carollustirtaagni-collab/proyek-kipas-edge-ai/data/_uji_i2c/sehat_u01_pwm100_20260928-003612.png

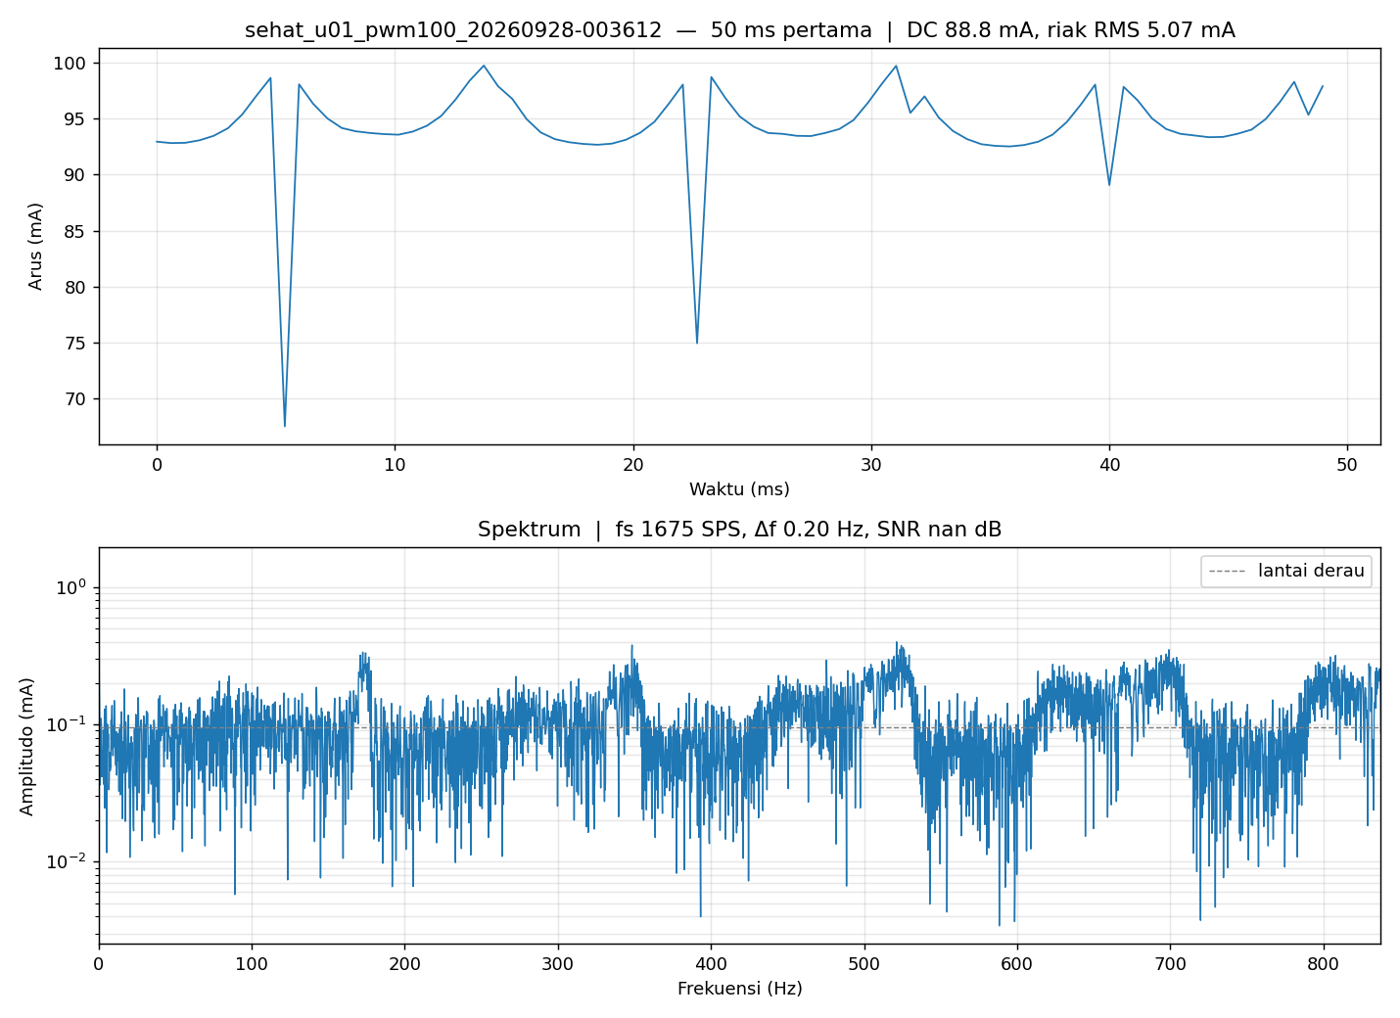
data/_uji_i2c/sehat_u01_pwm100_20260928-003612.png
