carollustirtaagni-collab/proyek-kipas-edge-ai/data/_uji_led/cek-led_20261019-214011.png

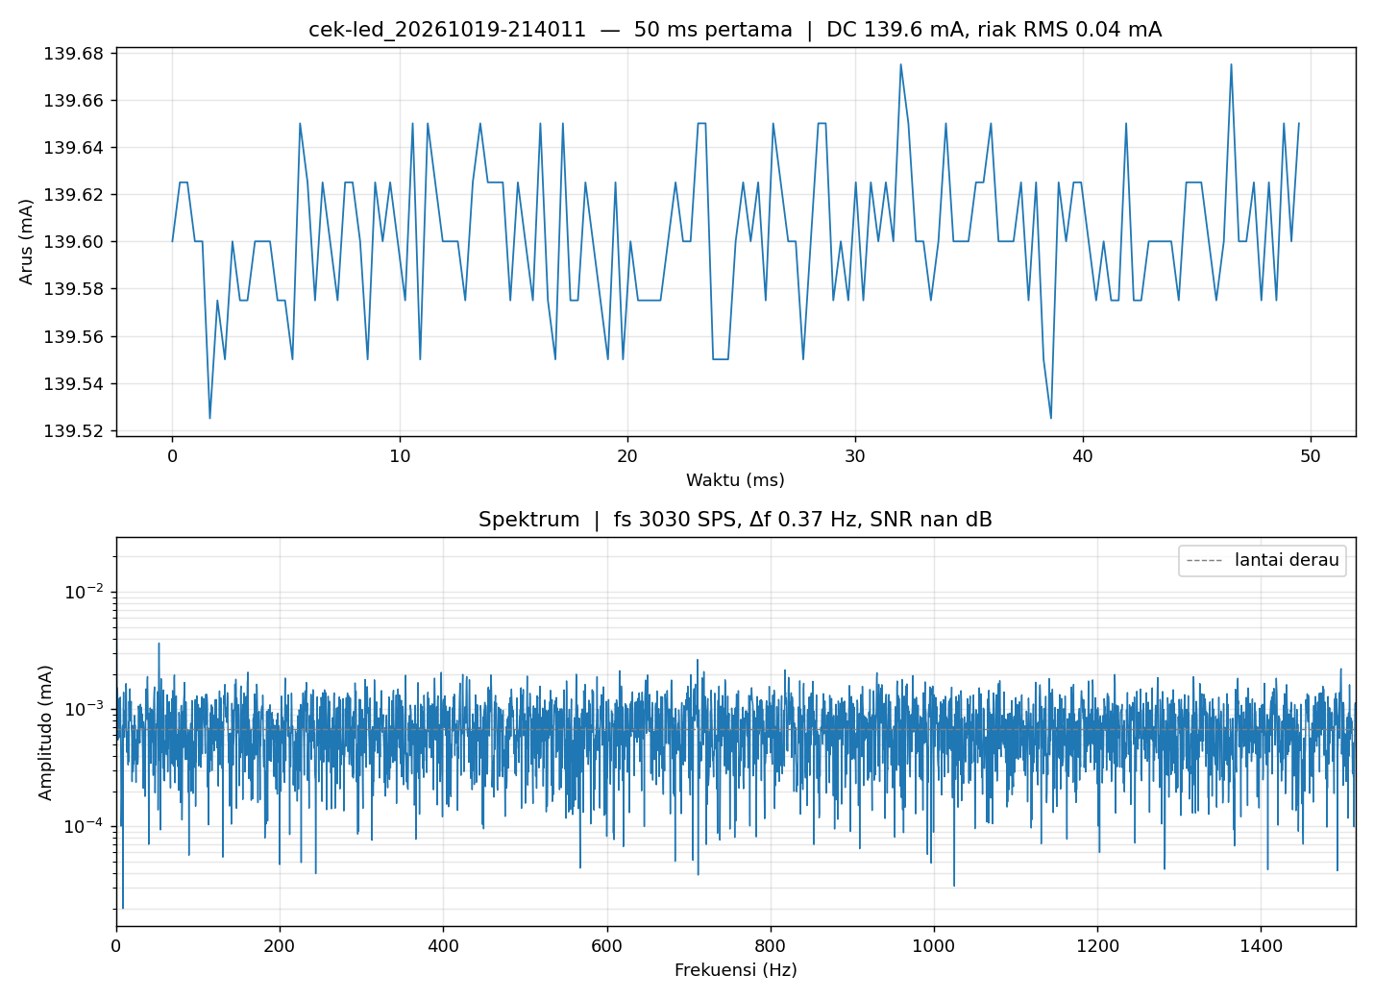
data/_uji_led/cek-led_20261019-214011.png
