carollustirtaagni-collab/proyek-kipas-edge-ai/data/_uji_led/cek-led_20261019-214037.png

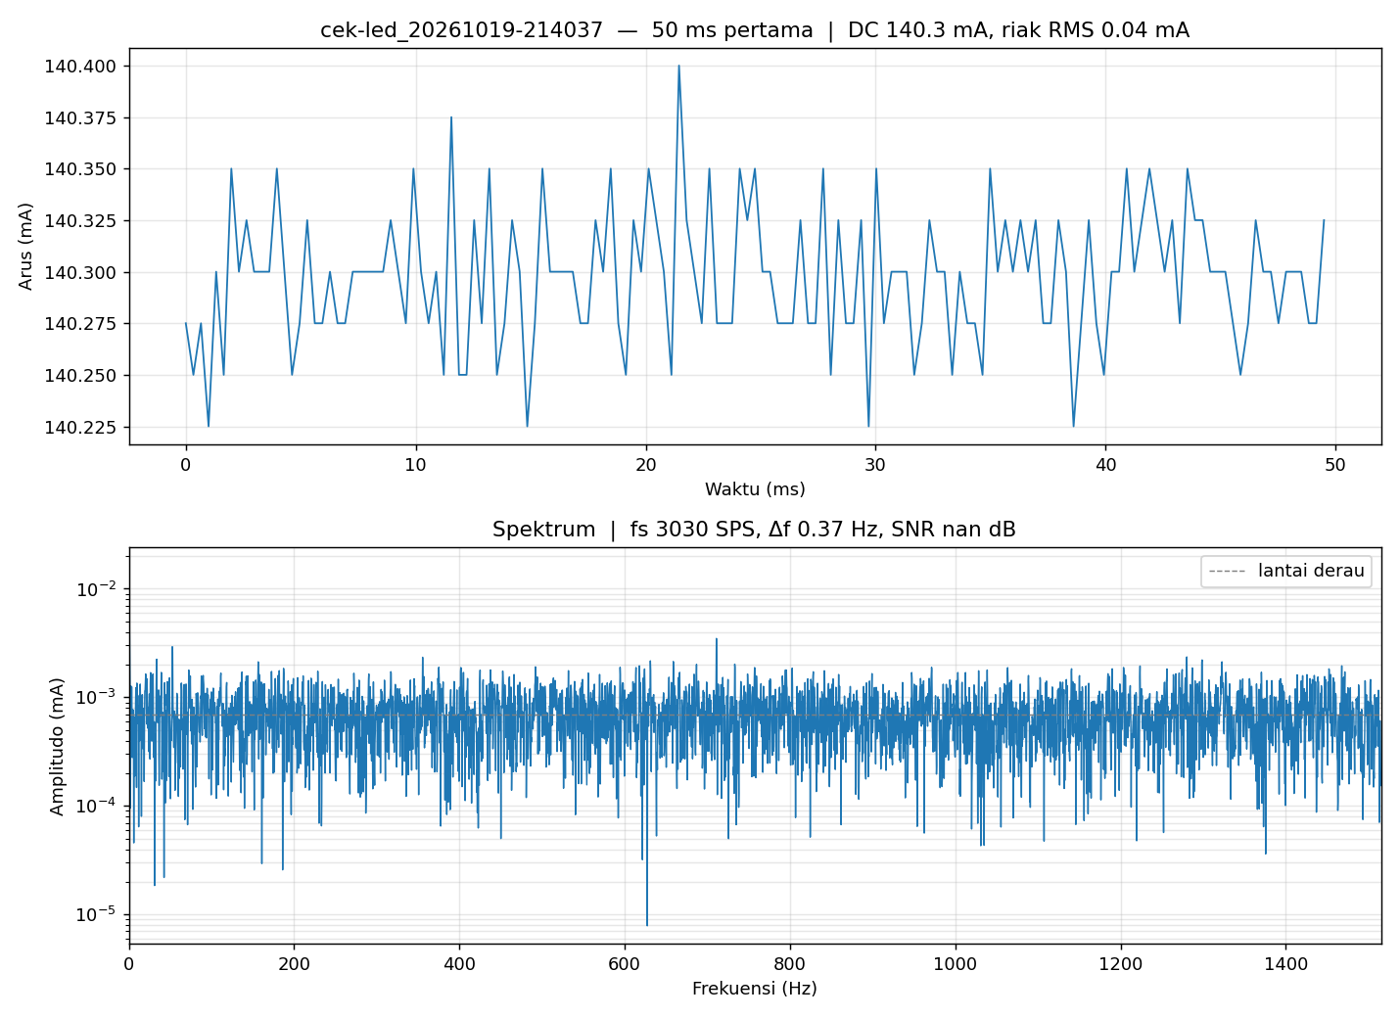
data/_uji_led/cek-led_20261019-214037.png
