carollustirtaagni-collab/proyek-kipas-edge-ai/data/_uji_led/cek-ledpendek2_20261019-215009.png

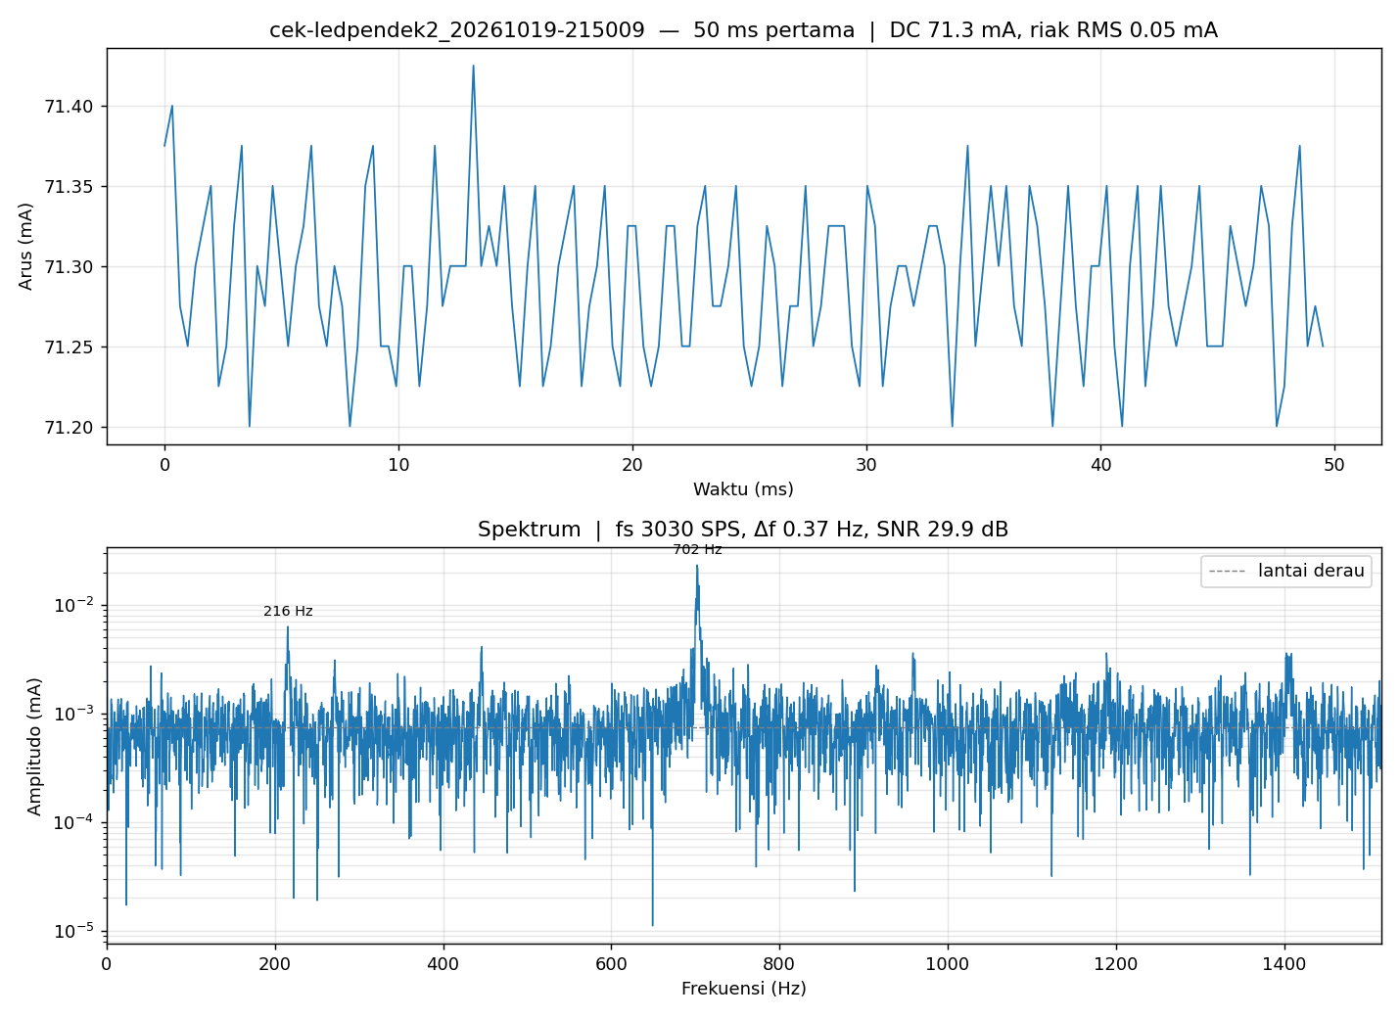
data/_uji_led/cek-ledpendek2_20261019-215009.png
