carollustirtaagni-collab/proyek-kipas-edge-ai/data/_uji_led/cek-ledpendek_20261019-214843.png

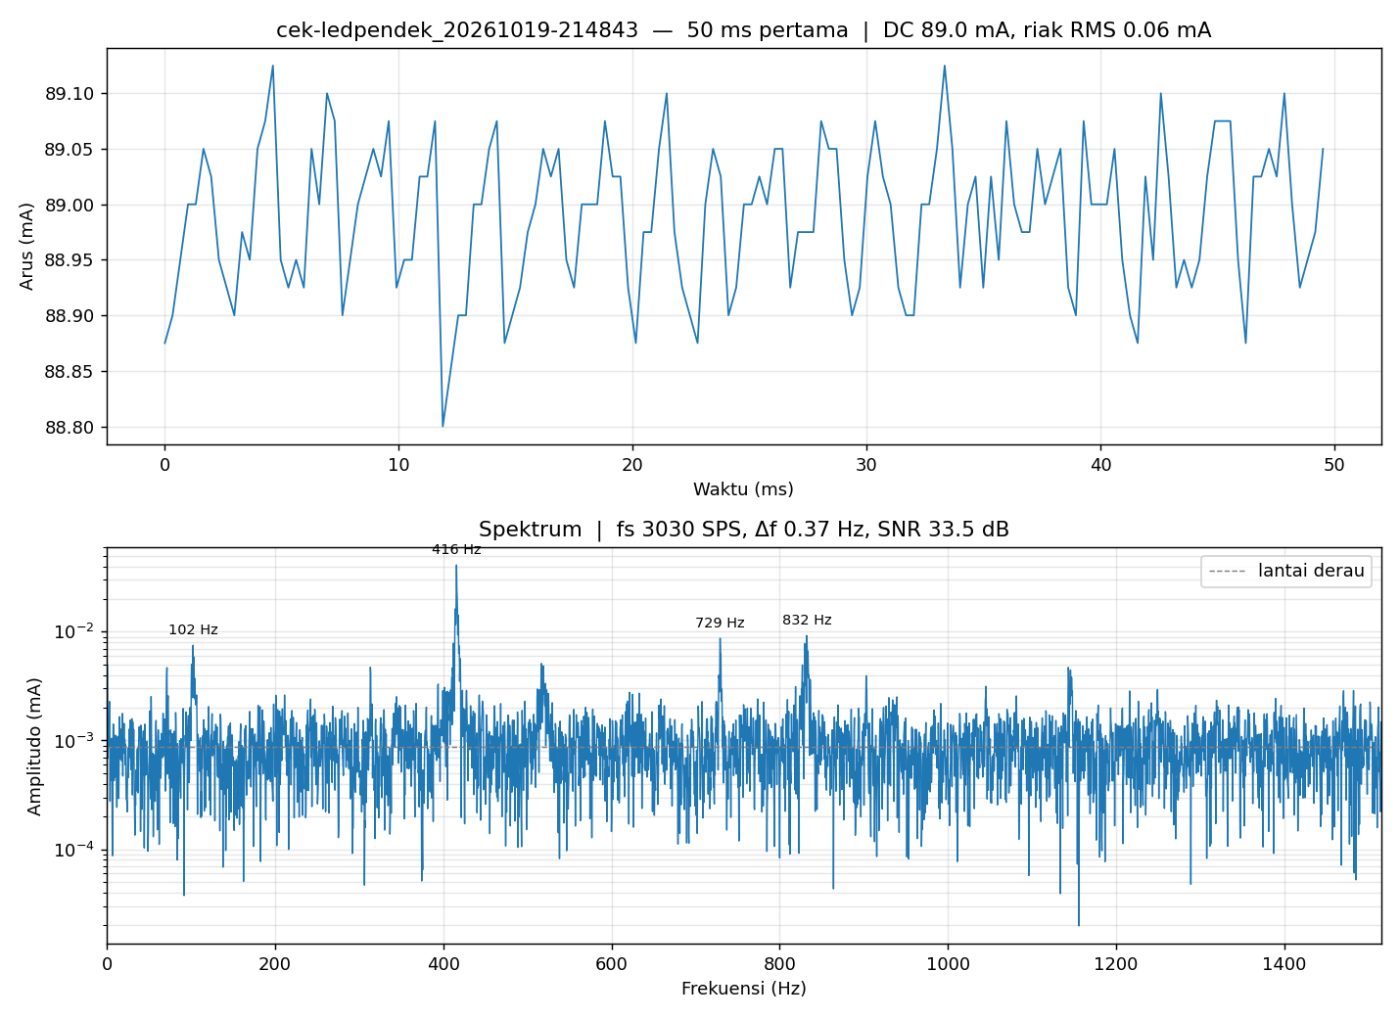
data/_uji_led/cek-ledpendek_20261019-214843.png
