carollustirtaagni-collab/proyek-kipas-edge-ai/data/_uji_multimeter/cek-multimeter_u01_20260928-232610.png

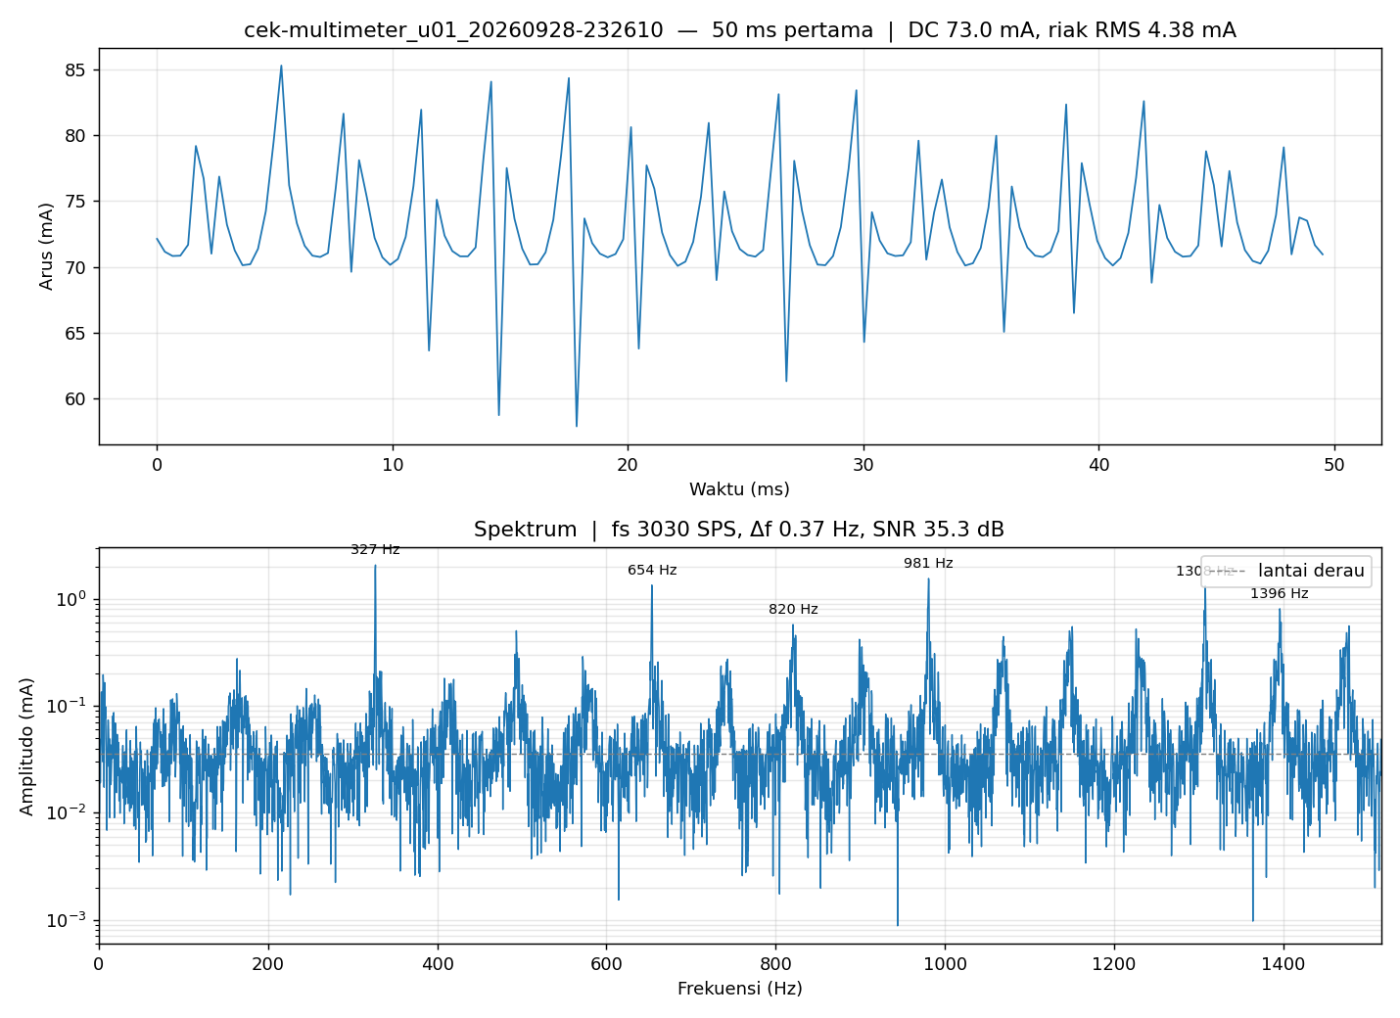
data/_uji_multimeter/cek-multimeter_u01_20260928-232610.png
