carollustirtaagni-collab/proyek-kipas-edge-ai/data/_uji_multimeter/cek-mv_u01_20260928-233632.png

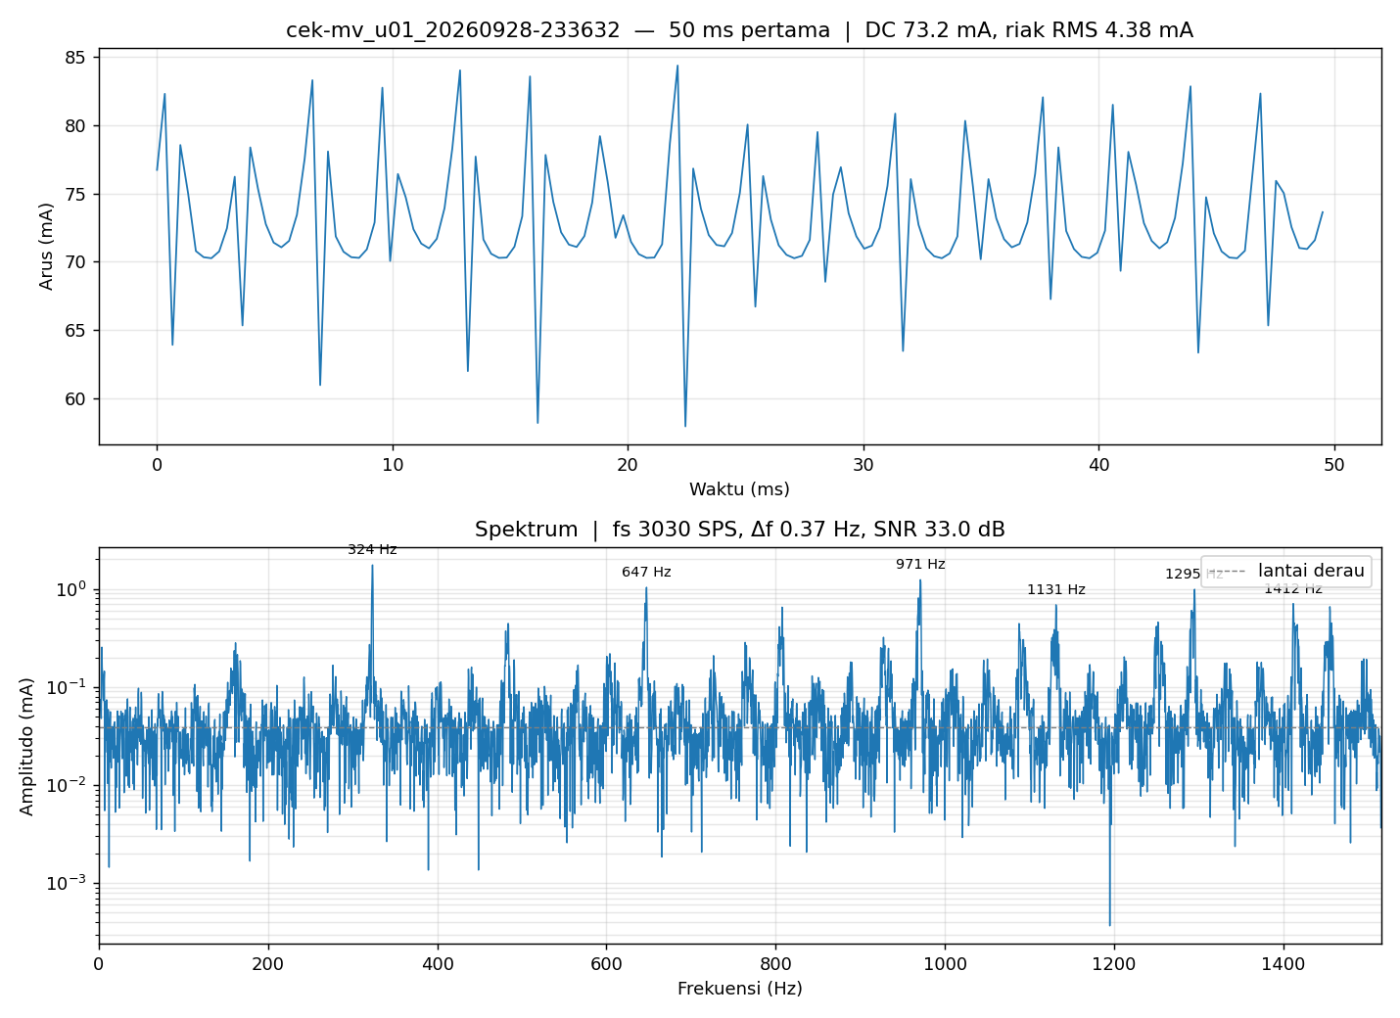
data/_uji_multimeter/cek-mv_u01_20260928-233632.png
