carollustirtaagni-collab/proyek-kipas-edge-ai/data/perbandingan_u01_s1_s2.png

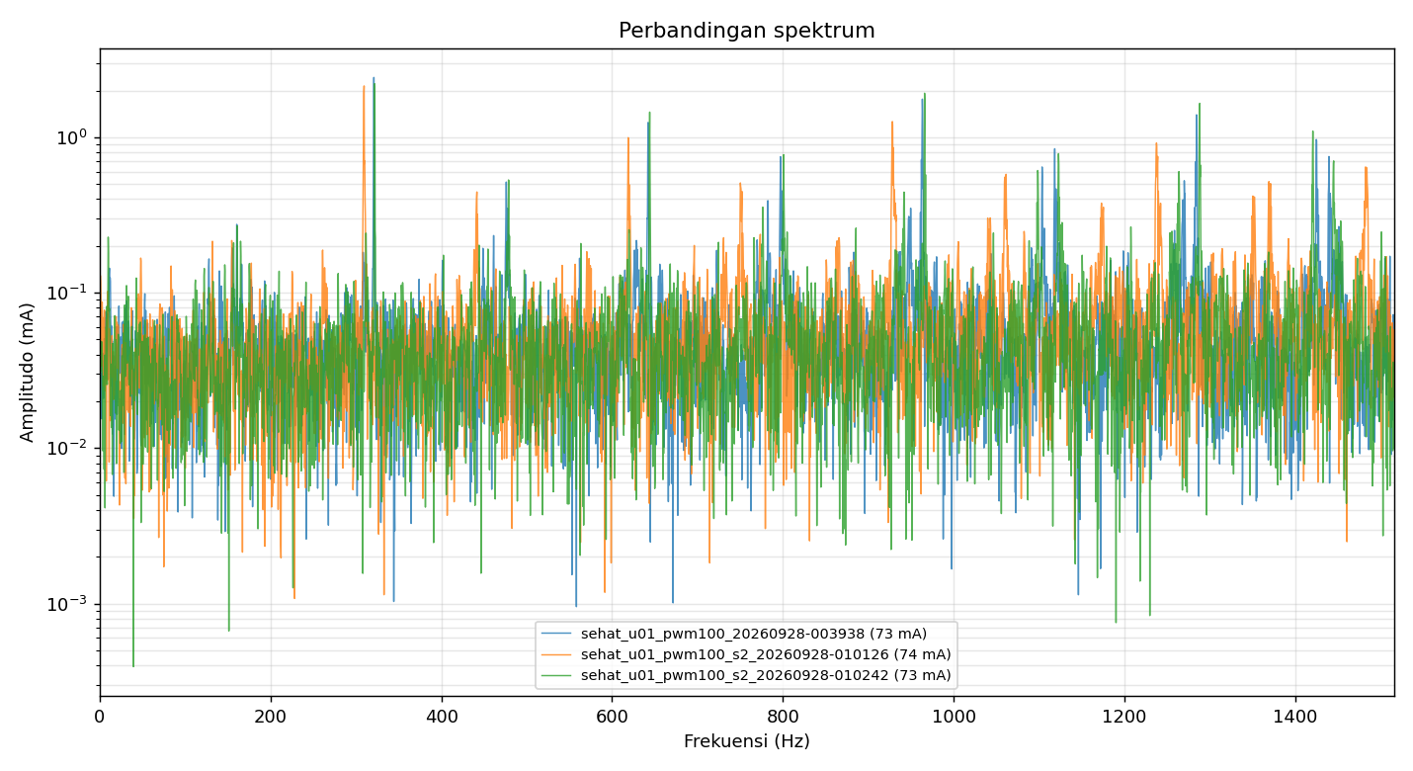
data/perbandingan_u01_s1_s2.png
