carollustirtaagni-collab/proyek-kipas-edge-ai/data/sehat_u01_pwm100_20260928-003938.png

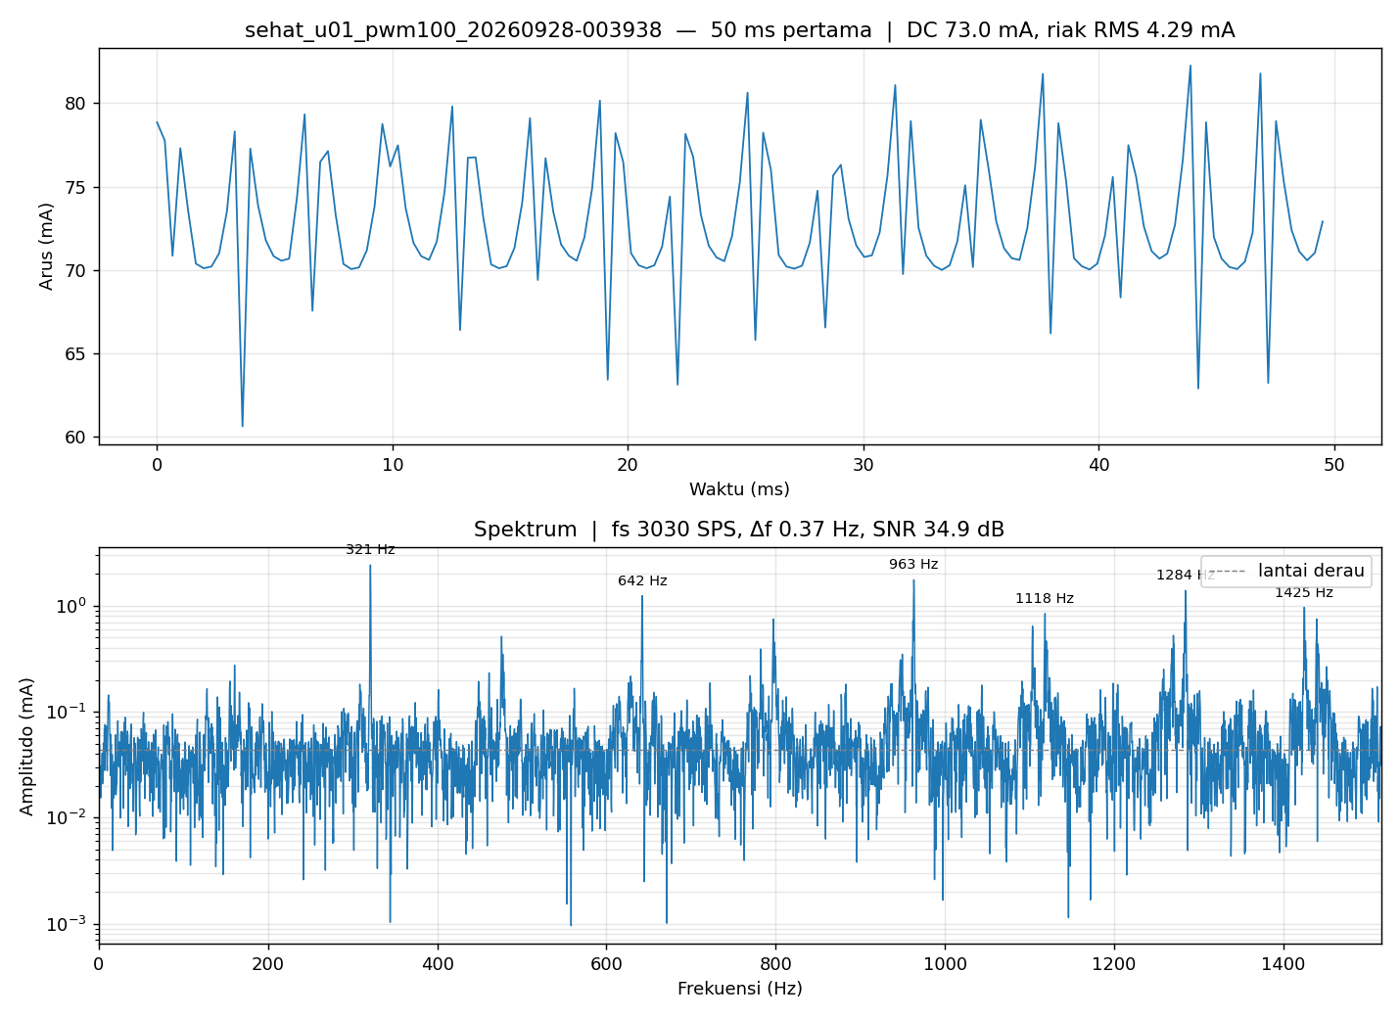
data/sehat_u01_pwm100_20260928-003938.png
