carollustirtaagni-collab/proyek-kipas-edge-ai/data/sehat_u01_pwm100_s2_20260928-010126.png

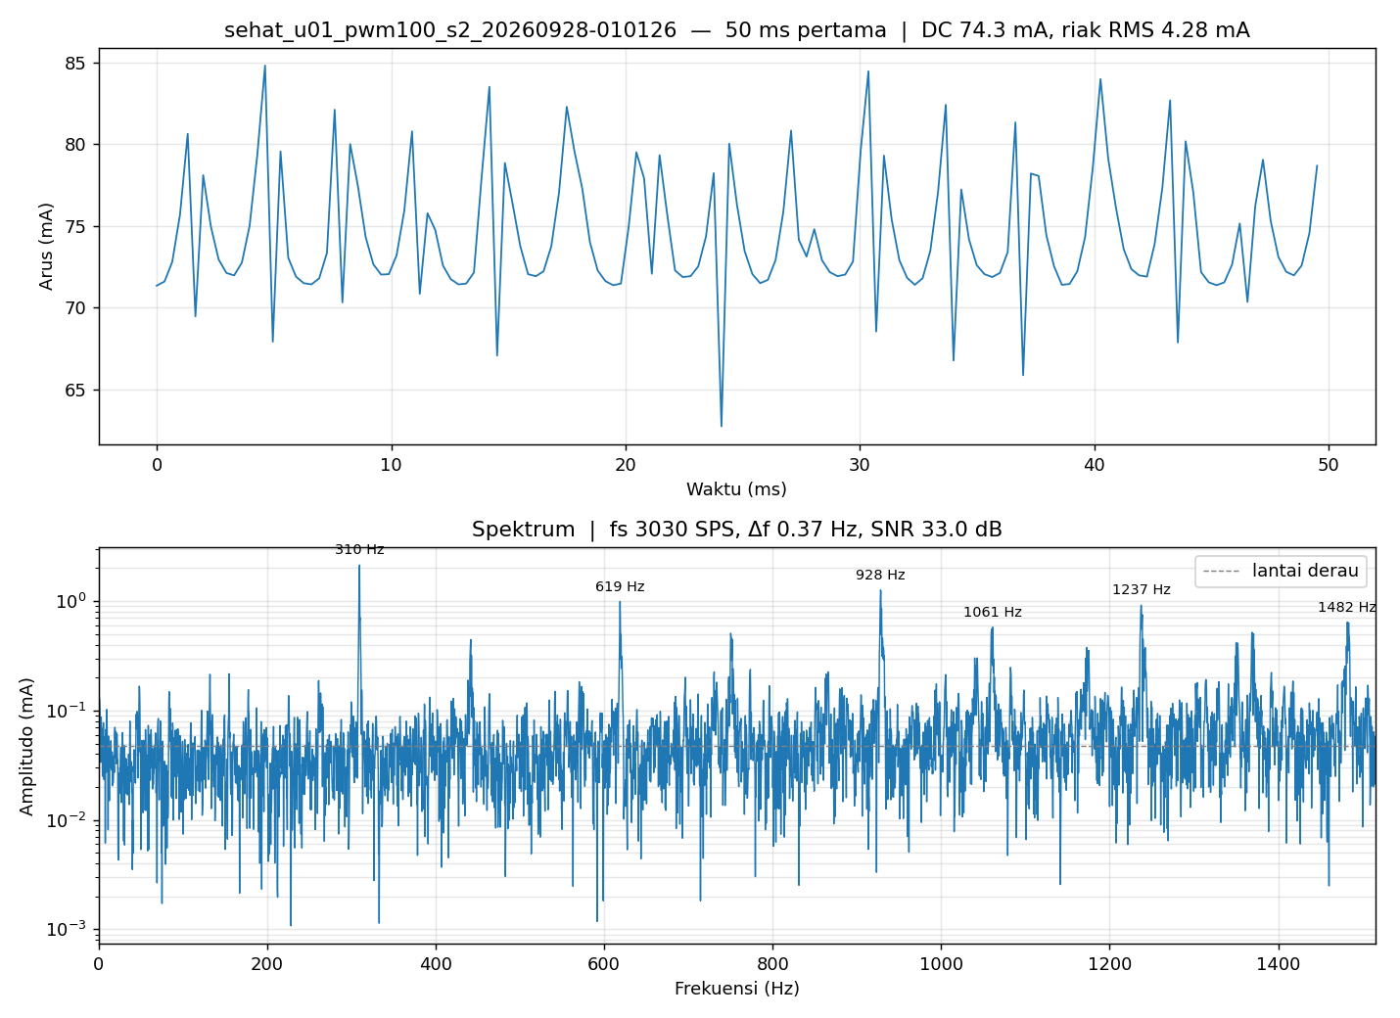
data/sehat_u01_pwm100_s2_20260928-010126.png
