carollustirtaagni-collab/proyek-kipas-edge-ai/data/sehat_u01_pwm100_s3_20260929-000622.png

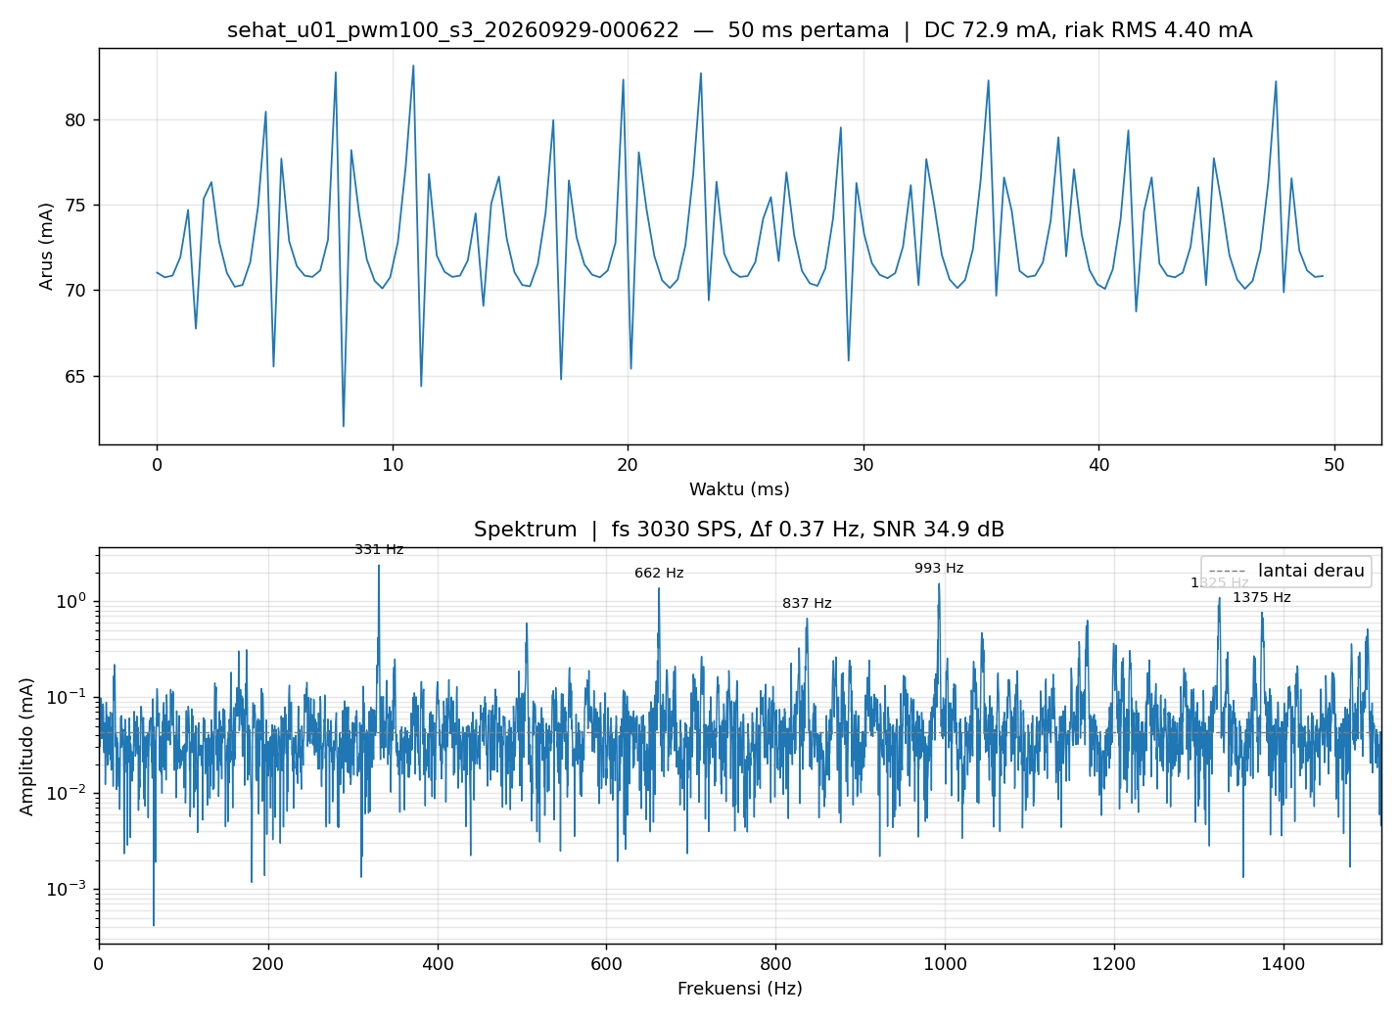
data/sehat_u01_pwm100_s3_20260929-000622.png
