carollustirtaagni-collab/proyek-kipas-edge-ai/data/sehat_u01_pwm100_s3_20260929-000630.png

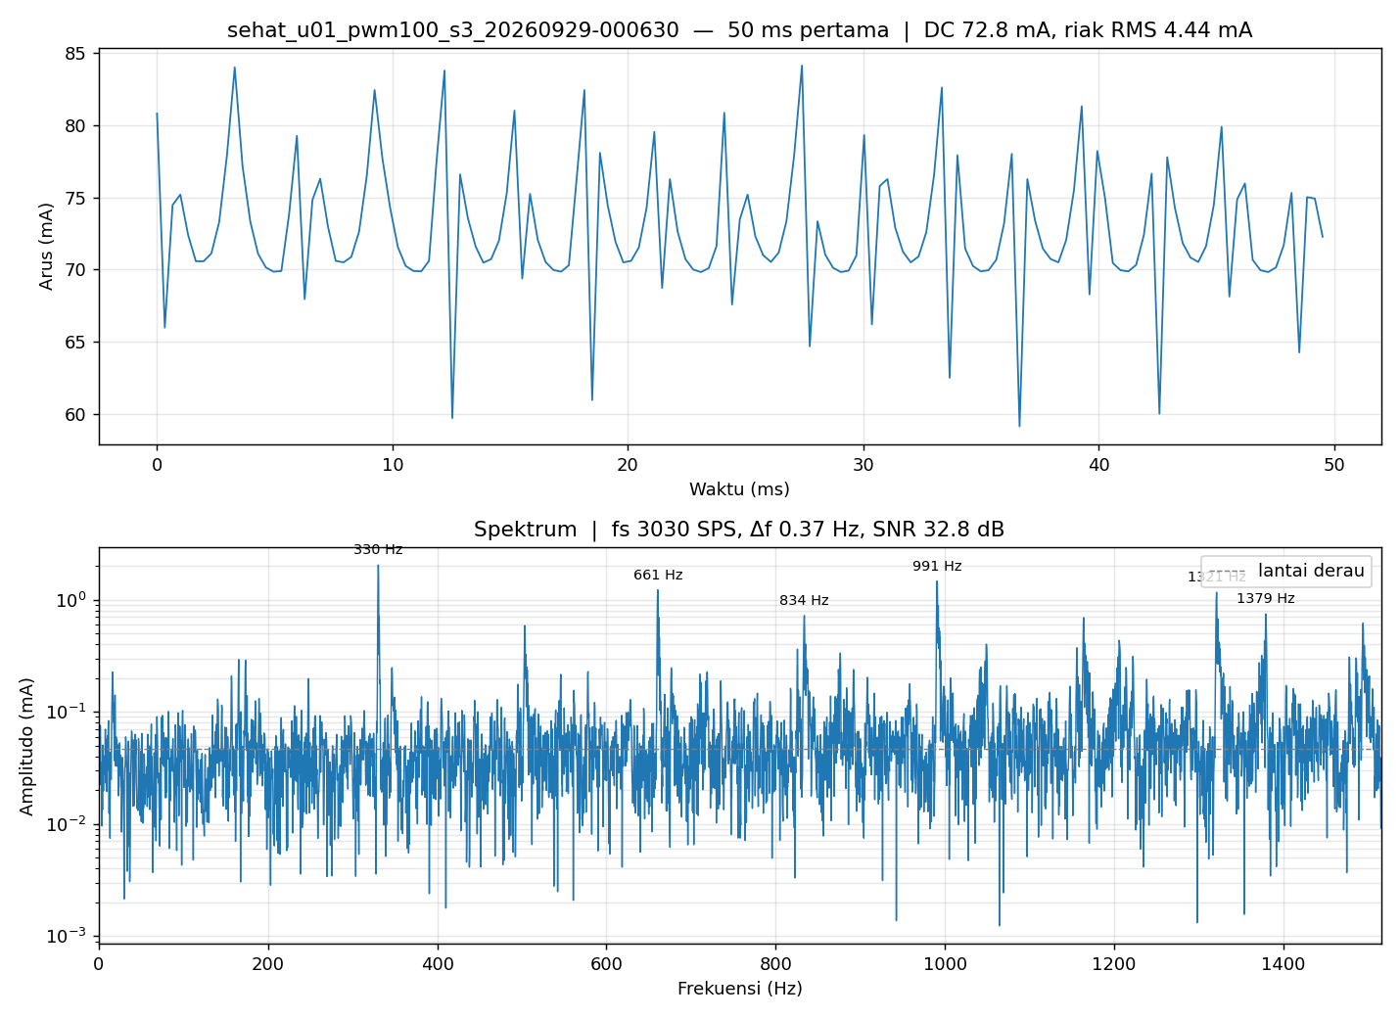
data/sehat_u01_pwm100_s3_20260929-000630.png
