carollustirtaagni-collab/proyek-kipas-edge-ai/data/sehat_u02_pwm100_s3_t0030_20260929-001050.png

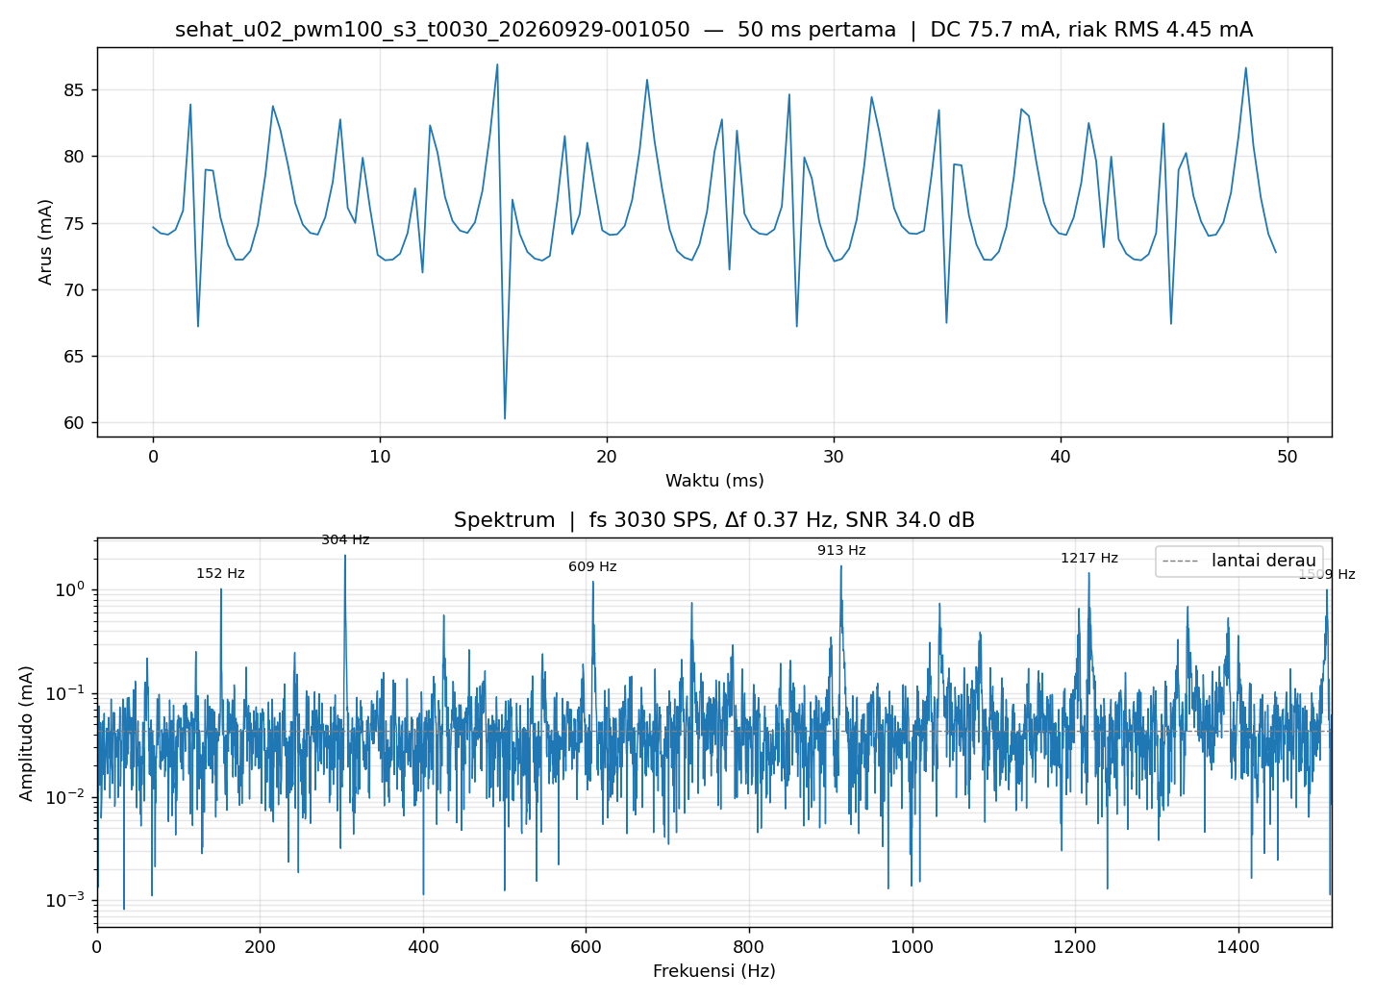
data/sehat_u02_pwm100_s3_t0030_20260929-001050.png
