carollustirtaagni-collab/proyek-kipas-edge-ai/data/sehat_u02_pwm100_s3_t0060_20260929-001120.png

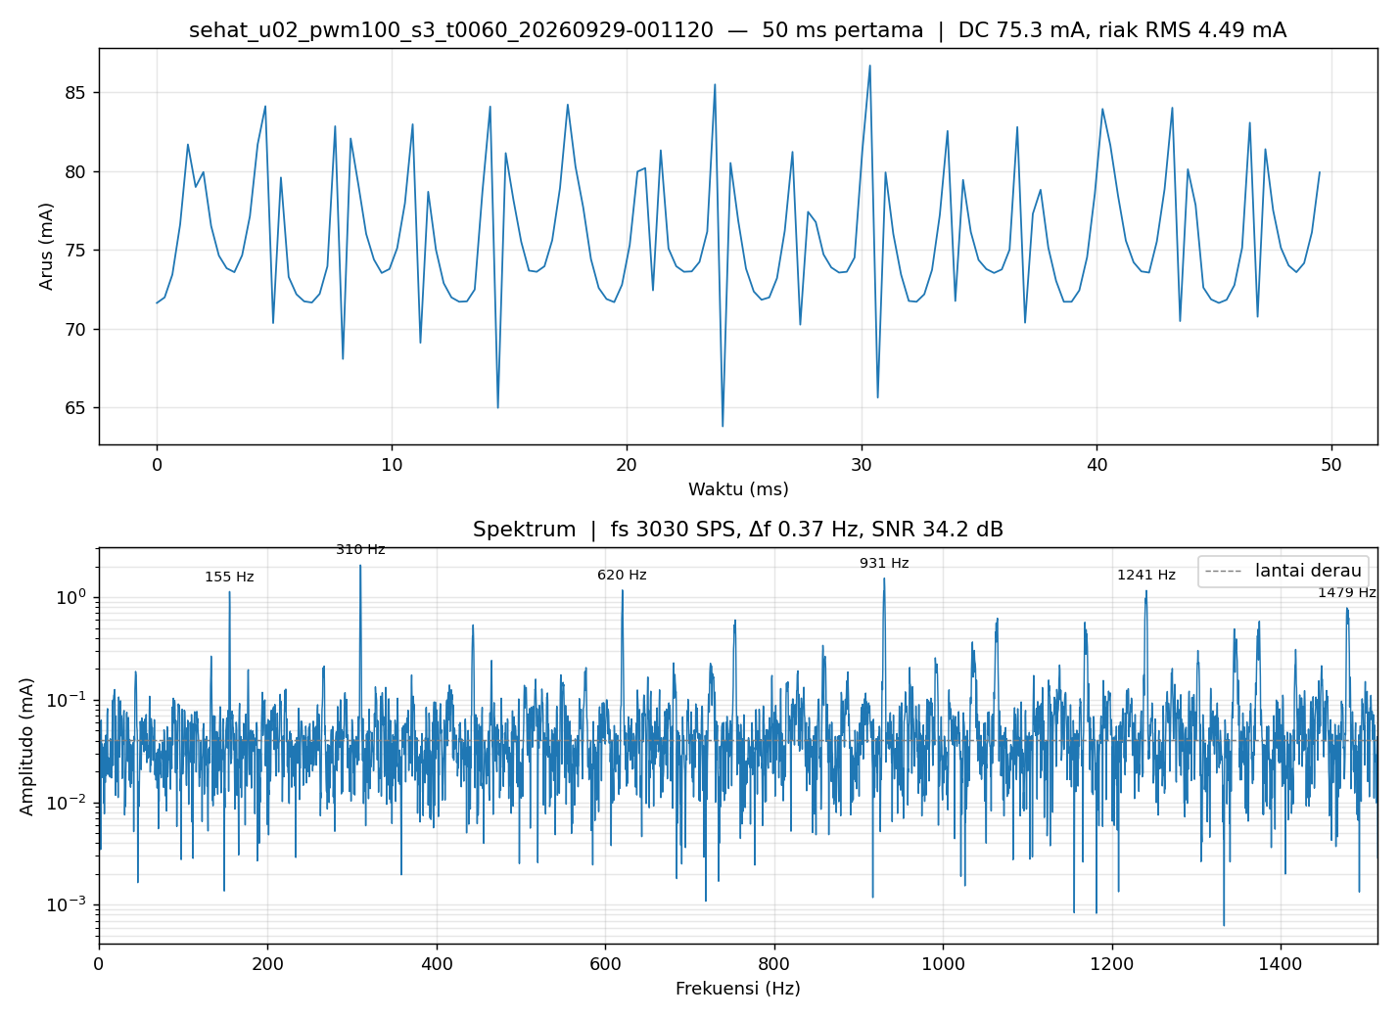
data/sehat_u02_pwm100_s3_t0060_20260929-001120.png
