carollustirtaagni-collab/proyek-kipas-edge-ai/data/sehat_u02_pwm100_s3_t0120_20260929-001220.png

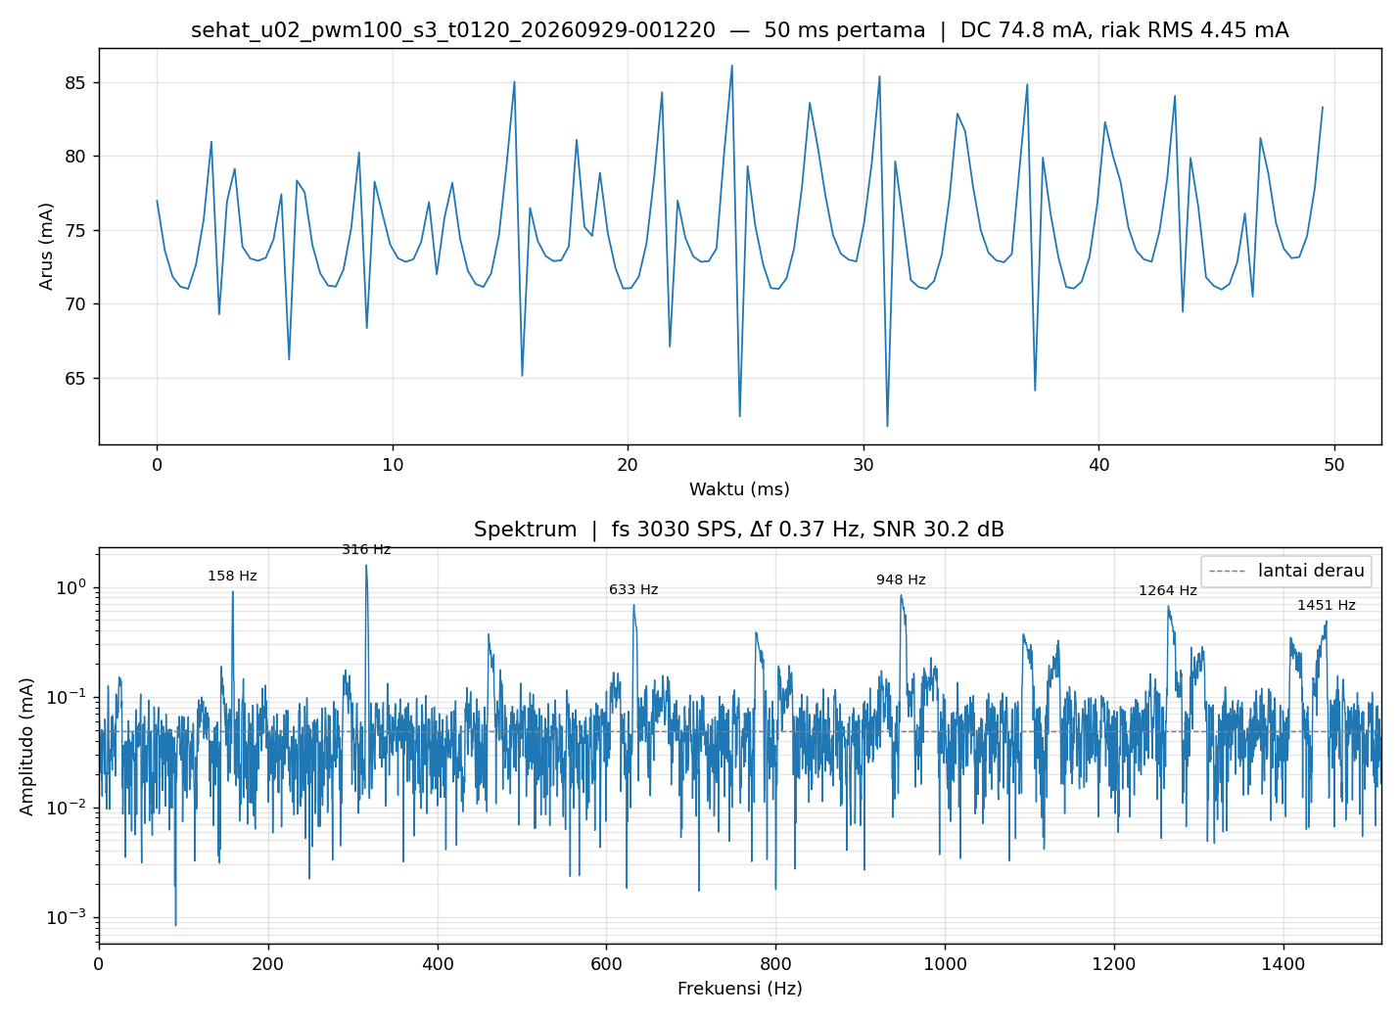
data/sehat_u02_pwm100_s3_t0120_20260929-001220.png
