carollustirtaagni-collab/proyek-kipas-edge-ai/data/sehat_u02_pwm100_s3_t0180_20260929-001320.png

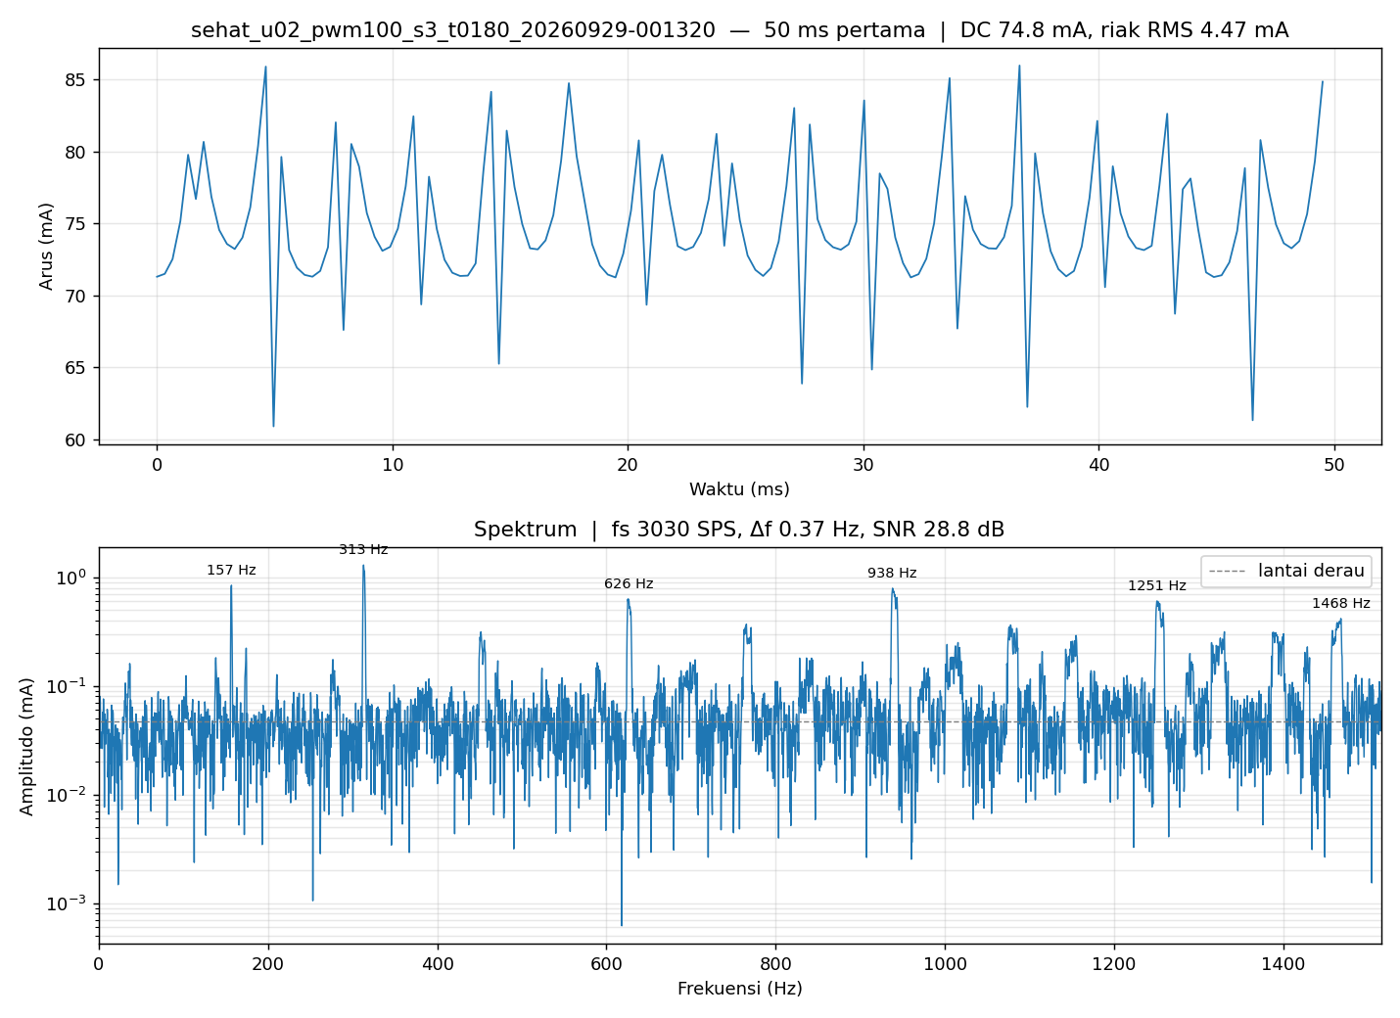
data/sehat_u02_pwm100_s3_t0180_20260929-001320.png
