carollustirtaagni-collab/proyek-kipas-edge-ai/data/sehat_u02_pwm100_s3_t0300_20260929-001520.png

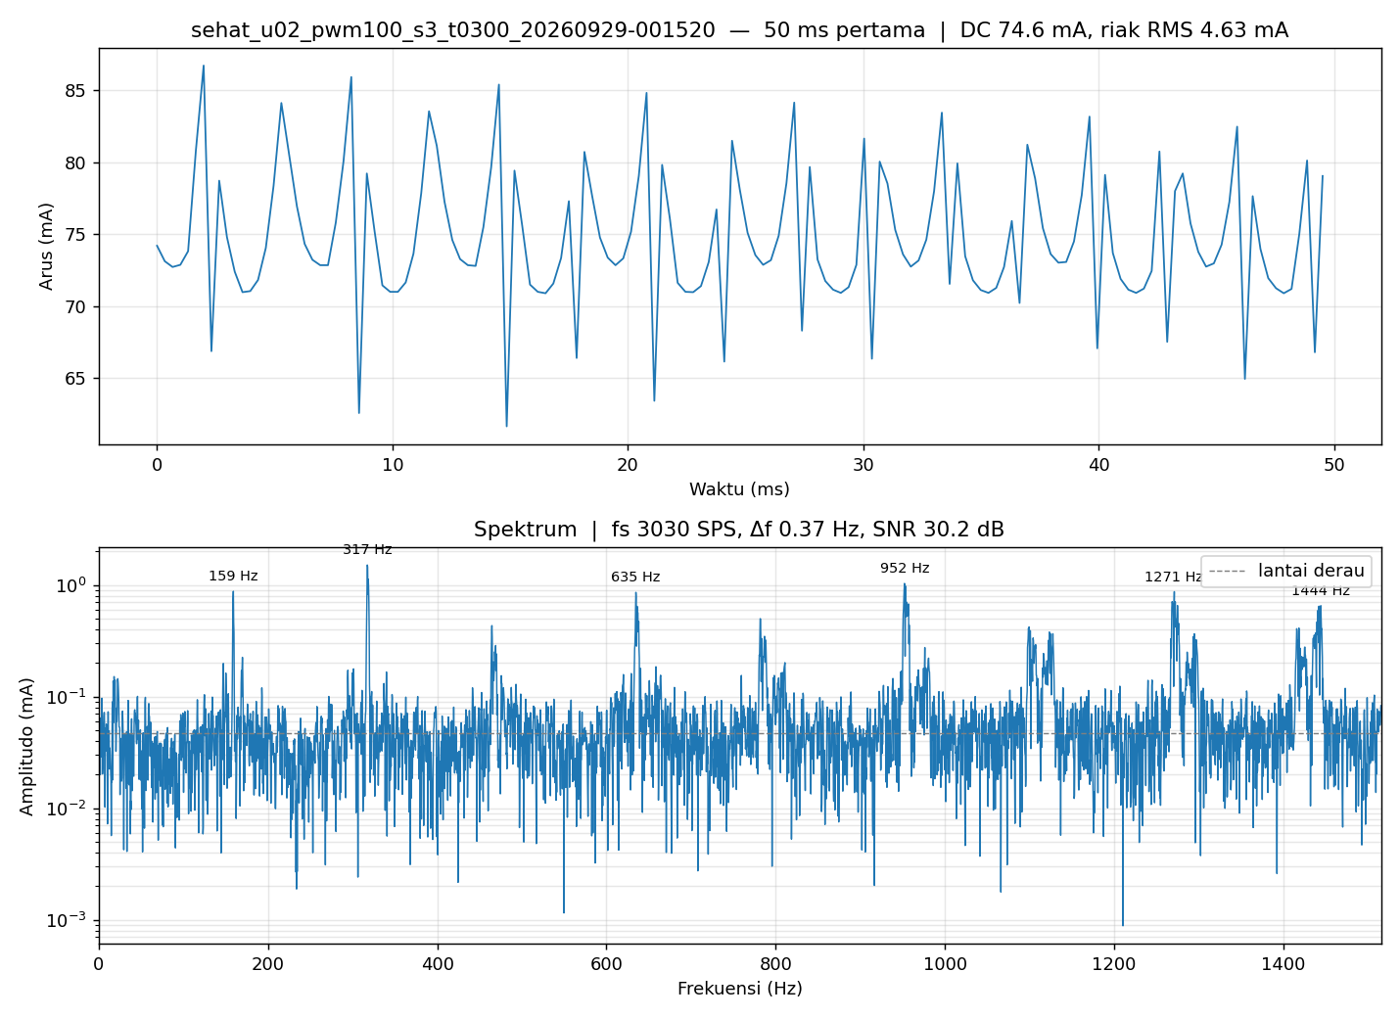
data/sehat_u02_pwm100_s3_t0300_20260929-001520.png
