carollustirtaagni-collab/proyek-kipas-edge-ai/data/sehat_u02_pwm100_s3_t0420_20260929-001721.png

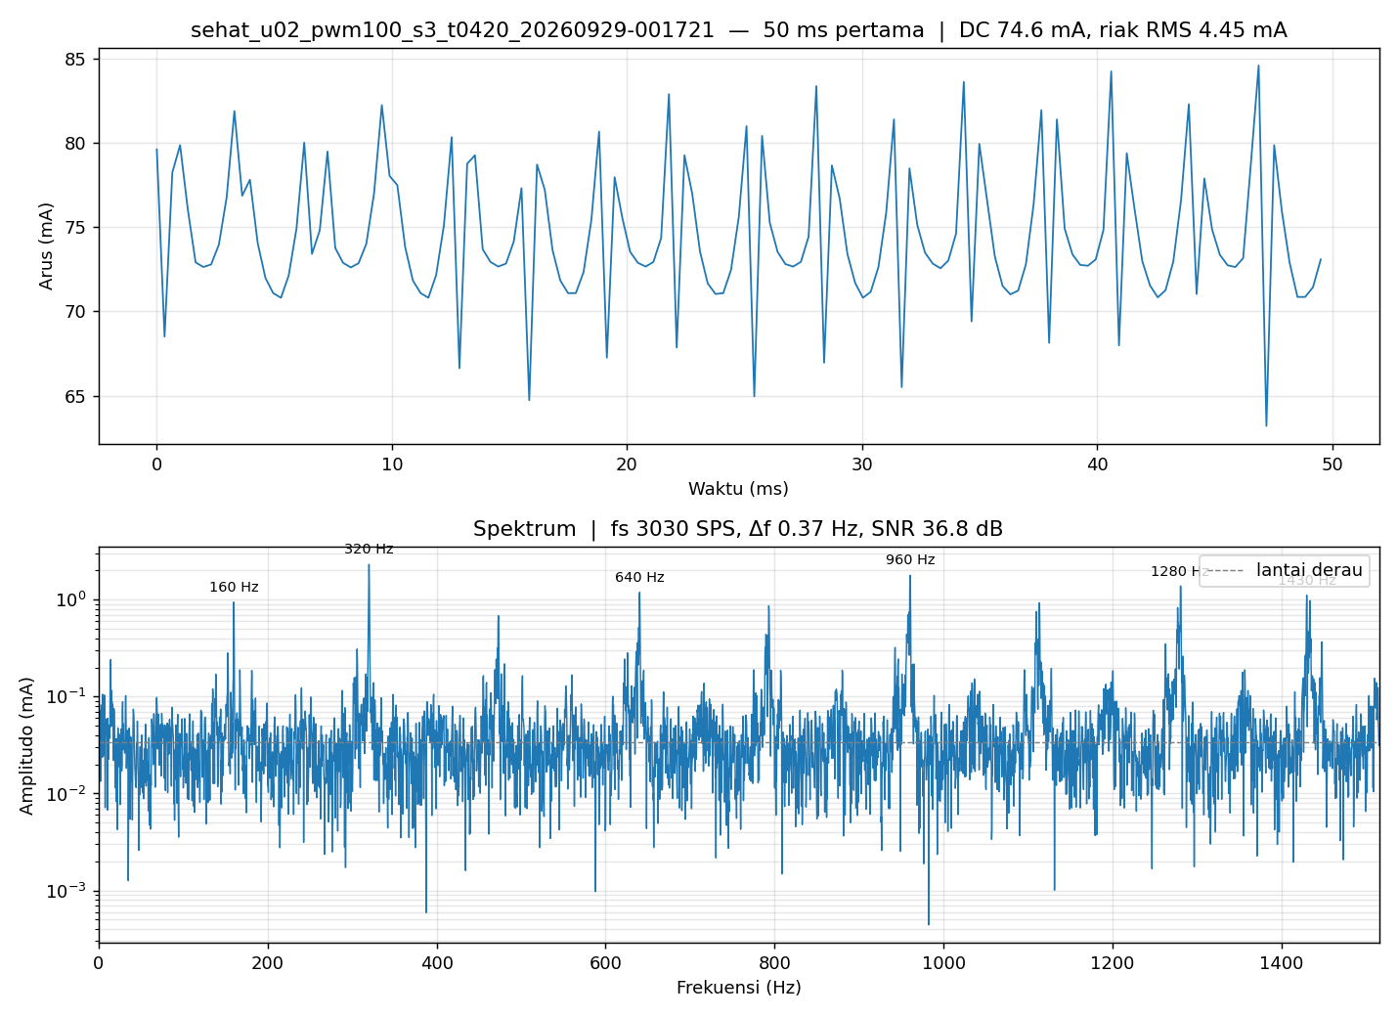
data/sehat_u02_pwm100_s3_t0420_20260929-001721.png
