carollustirtaagni-collab/proyek-kipas-edge-ai/data/sehat_u02_pwm100_s3_t0600_20260929-002021.png

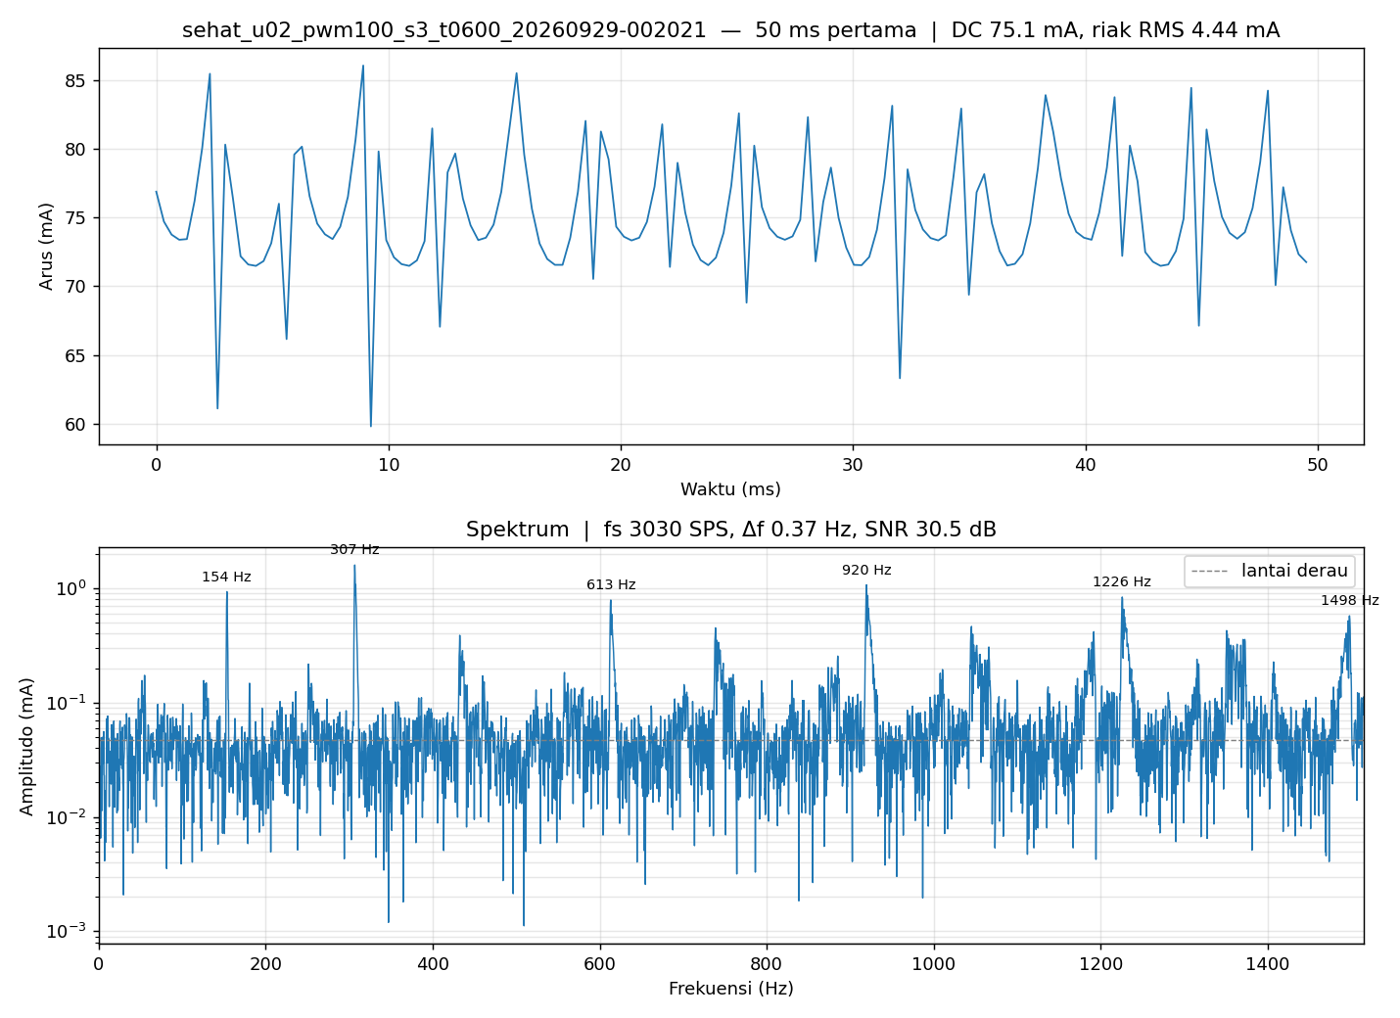
data/sehat_u02_pwm100_s3_t0600_20260929-002021.png
