carollustirtaagni-collab/proyek-kipas-edge-ai/docs/foto/stiker_FAN5010DC.jpg

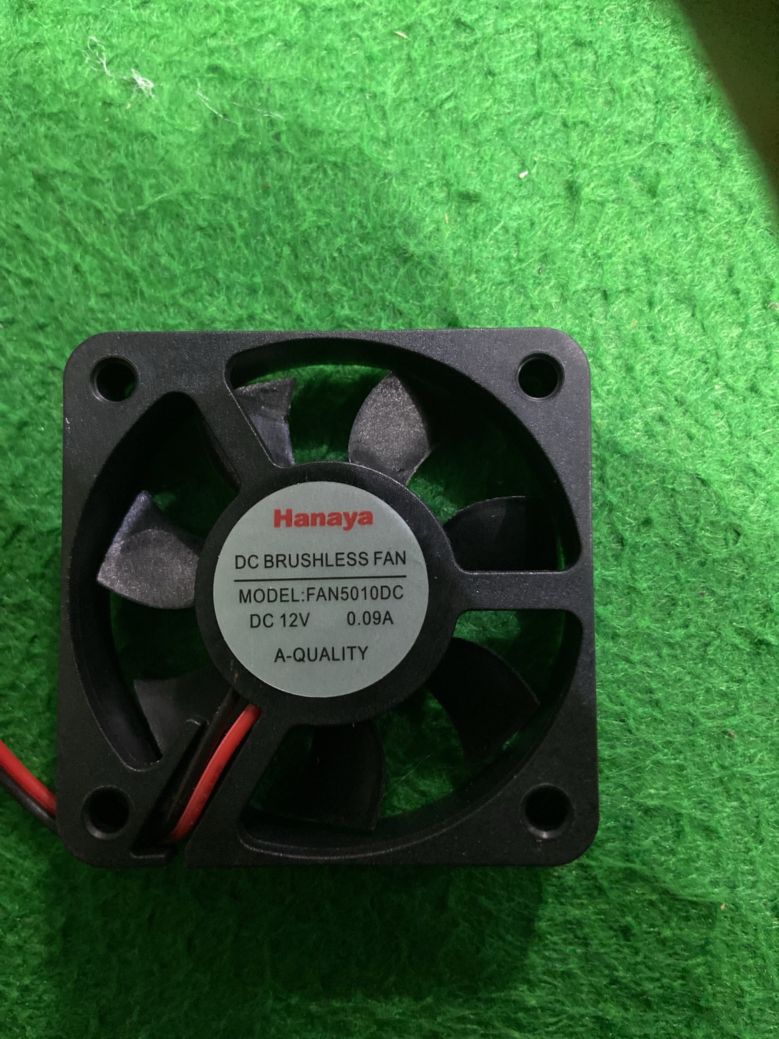
docs/foto/stiker_FAN5010DC.jpg
