carollustirtaagni-collab/proyek-kipas-edge-ai/firmware/03_klasifikasi/model_data.h

// Dibuat otomatis oleh tools/ekspor_model.py — jangan diedit manual.
#pragma once
#include <stdint.h>

#define MODEL_N_IN 7
#define MODEL_N_H1 32
#define MODEL_N_H2 16
#define MODEL_N_OUT 3
#define MODEL_BATAS_ARUS 0.25f

// Urutan masukan: riak_dc, kurtosis, crest, flat, lantai_rel, d_log_dc, d_riak_dc
// Kelas: 0=Sehat, 1=Aliran Terhambat, 2=Tidak Dikenal

static const float CLIP_LO[7] = {
  0.000216357497f, -0.599199355f, 2.65429735f, 0.030960938f, -1.89066458f, -0.124938734f, -0.241833881f
};

static const float CLIP_HI[7] = {
  0.269548625f, 4.92818308f, 4.23280478f, 0.586232841f, -1.11877787f, 0.0969100147f, 0.0649364144f
};

static const float SC_MEAN[7] = {
  0.160088396f, 2.5189986f, 3.65639688f, 0.134265702f, -1.53696322f, 0.00590528059f, -0.00972737449f
};

static const float SC_STD[7] = {
  0.0955190722f, 1.62068079f, 0.318739256f, 0.0888464939f, 0.124346918f, 0.026507241f, 0.0451619208f
};

static const float S_IN0 = 0.0404675401f;

static const int8_t MDL_W1[224] = {
  -14, -26, -57, 12, 27, 83, -41, 23, 7, -6, -71, -23, -64, 58, 24, -55,
  37, 45, 10, 74, 25, -18, 28, -31, -44, 26, 117, 37, -37, -6, 38, 35,
  -23, 127, -25, 7, 6, -58, -17, -8, 92, -37, -30, 39, 41, 57, 20, -83,
  -83, 40, 9, -24, 73, 25, -37, -21, 97, 17, 72, -71, -13, 7, -57, -9,
  -2, 21, 7, 15, -47, 32, 69, 46, 34, -11, -2, -31, -2, -3, -55, -40,
  21, 2, -94, -53, 10, 26, -23, -42, 47, -41, -57, 49, 13, -62, 74, -10,
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
  -58, 13, -84, 65, -87, -127, -54, 66, 37, -44, -48, 78, -27, -45, 54, 22,
  -19, -88, -3, 71, 16, -15, 76, -27, -58, 60, -35, -17, 0, 82, 56, -74
};

static const int32_t MDL_B3[3] = {
  560, 368, 243
};

static const float MDL_M3 = 0.00071277289f;  // skala logit
