carollustirtaagni-collab/proyek-kipas-edge-ai/(commit log)

2026-09-27 Sketch 01 lulus: ID INA226 OK di 0x44; catat lingkungan (COM14, arduino-cli)
2026-09-27 Tahap C: FFT pertama 3030 SPS; perbaiki urutan baca flag, I2C 1 MHz, deteksi konversi terlewat
    [sehat_u01_pwm100_20260928-003612.csv, sehat_u01_pwm100_20260928-003805.csv, sehat_u01_pwm100_20260928-003938.csv]
2026-09-27 Rekam ulang U01 dengan kapasitor PSU; catat tegangan bus tiap rekaman
    [sehat_u01_pwm100_s2_20260928-010126.csv, sehat_u01_pwm100_s2_20260928-010242.csv]
2026-09-28 Restrukturisasi dokumentasi: README.md sebagai dokumen utama proyek
    - Dokumentasi proyek dipindahkan ke README.md dengan format formal
    - Catatan kerja lokal dikeluarkan dari repositori (.gitignore)
    - Log eksperimen: verifikasi multimeter U01 dan dudukan kipas terstandar
    [cek-multimeter_u01_20260928-232610.csv]
2026-09-28 Log kalibrasi arus: pengukuran mV terminal shunt U01
    [cek-mv_u01_20260928-233632.csv]
2026-09-28 Rekam U01 sesi s3 pada dudukan terstandar
    [sehat_u01_pwm100_s3_20260929-000622.csv, sehat_u01_pwm100_s3_20260929-000630.csv]
2026-09-28 Uji pemanasan U02: variasi kecepatan kipas sehat 30-600 s
    [sehat_u02_pwm100_s3_t0030_20260929-001050.csv, sehat_u02_pwm100_s3_t0060_20260929-001120.csv, sehat_u02_pwm100_s3_t0120_20260929-001220.csv, sehat_u02_pwm100_s3_t0180_20260929-001320.csv, sehat_u02_pwm100_s3_t0300_20260929-001520.csv, sehat_u02_pwm100_s3_t0420_20260929-001721.csv, sehat_u02_pwm100_s3_t0600_20260929-002021.csv]
2026-10-05 Rekam beruntun U01 sesi s4 (150 rekaman); tambah mode --count/--note
    [sehat_u01_pwm100_s4_20261005-211527.csv, sehat_u01_pwm100_s4_20261005-211531.csv, sehat_u01_pwm100_s4_20261005-211535.csv, sehat_u01_pwm100_s4_20261005-211539.csv, sehat_u01_pwm100_s4_20261005-211543.csv, sehat_u01_pwm100_s4_20261005-211547.csv, sehat_u01_pwm100_s4_20261005-211551.csv, sehat_u01_pwm100_s4_20261005-211555.csv]
2026-10-05 Data mentah CSV tidak lagi disimpan di repositori (dipindah ke Google Drive)
    [cek-multimeter_u01_20260928-232610.csv, cek-mv_u01_20260928-233632.csv, sehat_u01_pwm100_20260928-003612.csv, sehat_u01_pwm100_20260928-003805.csv, sehat_u01_pwm100_20260928-003938.csv, sehat_u01_pwm100_s2_20260928-010126.csv, sehat_u01_pwm100_s2_20260928-010242.csv, sehat_u01_pwm100_s3_20260929-000622.csv]
2026-10-05 Rekam beruntun U02 sesi s4; dokumentasi penyimpanan data di Google Drive
2026-10-16 Rapikan langkah berikutnya di README
2026-10-16 Blokade dipasang di sisi tiup (sisi hisap tanpa penyangga)
2026-10-19 Sesi s5 tahap 3: kelas Tidak Dikenal (tanpa beban, LED, dua kipas, transisi)
2026-10-19 Massa kelas Tidak Seimbang: kawat tembaga 0,9 mm, 3 x 6 mm
2026-10-19 Tahap 5: bilah patah U05 terdeteksi jelas di orde setengah
2026-10-19 Uji langsung firmware klasifikasi pada U11: Sehat, blokade, LED; latensi
2026-10-28 Log: performa di perangkat EON vs TensorFlow Lite
2026-10-28 Log: uji langsung firmware Edge Impulse (U07 dan LED pendek pada PCB)
2026-10-30 README: pemecahan masalah ESP32 tidak menyala dari PSU
